alessandrolandra/MFCS/ProjectProposal.txt

Proposal for Project

Proposal for Project - The moth flight control system (@Luca.Dalmasso @Omar Gai @Alessandro Landra)
The platform and architecture of interest: STM32F4xx microcontroller

A short description about the target application and context in which the firmware module can be implemented:
Application – The moth flight control system aims at replacing the standard mechanical control that allow the moth class skiffs to “fly” over the sea, with an electronic one, which determines the height of the boat using ultrasonic sensors and IMU, and changes consequently the angle of the flap mounted on the drift, to maintain a certain distance from the sea surface. This project comes from a real need of the Polito Sailing Team, a student team which designs and produces racing sailing skiffs and who aims at introducing physically this type of control system.
Target of the Project - Development of a firmware module for reading data from ultrasonic sensors, interfaced by HC-SR04 drivers (specific circuit JSN-SR04T-3.0), and an inertial platform (Bosch & Hillcrest BNO085) connected through I2C. This data must act as input of a software PID controller that determines the PWM parameters to be sent to a servo motor, to further change the angle of the flap.
Link to example code that can be used as starting point for the development of the firmware modules:
HC-SR04 https://stm32f4-discovery.net/2014/08/library-30-measure-distance-hc-sr04-stm32f4xx/
I2C https://stm32f4-discovery.net/2014/05/library-09-i2c-for-stm32f4xx/
PWM http://stm32f4-discovery.net/2014/05/stm32f4-stm32f429-discovery-pwm-tutorial/
UART and Flash https://stm32f4-discovery.net/2017/07/stm32-tutorial-efficiently-receive-uart-data-using-dma/
 
Link to datasheets and programming manuals:
Microcontroller documentation https://www.st.com/en/microcontrollers-microprocessors/stm32f4-series.html 
Generic datasheet (precise model of the F4 series still to be selected) https://www.st.com/resource/en/datasheet/stm32f407vg.pdf
BNO085 datasheet https://learn.adafruit.com/adafruit-9-dof-orientation-imu-fusion-breakout-bno085
Programming manual https://www.st.com/resource/en/programming_manual/dm00046982-stm32-cortexm4-mcus-and-mpus-programming-manual-stmicroelectronics.pdf
