alessandrolandra/MFCS/test/LedSwitch/docs/schematics/Schermata 2021-11-29 alle 18.59.03.png

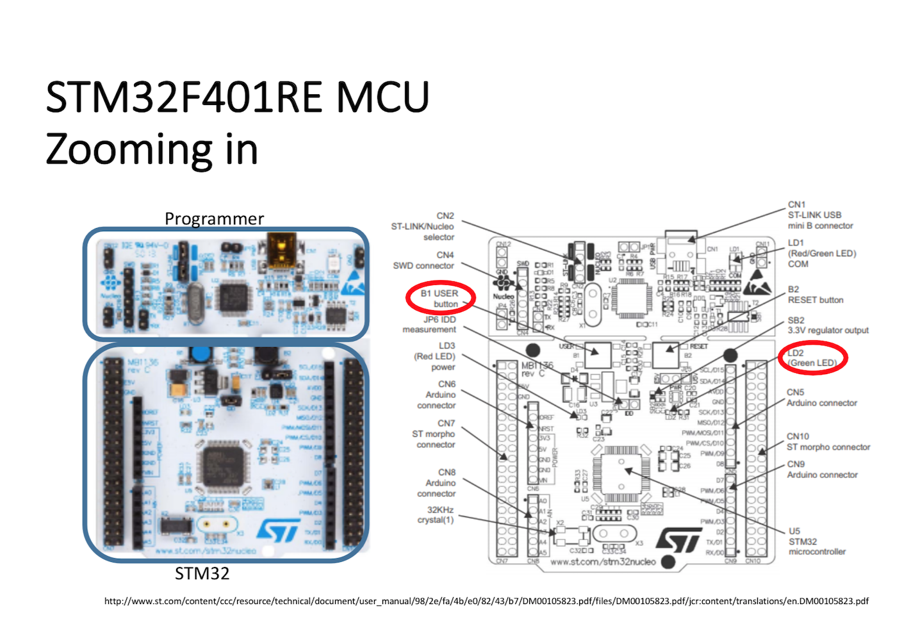
test/LedSwitch/docs/schematics/Schermata 2021-11-29 alle 18.59.03.png
