alessandrolandra/MFCS/test/LedSwitch/docs/schematics/Schermata 2021-11-29 alle 19.00.48.png

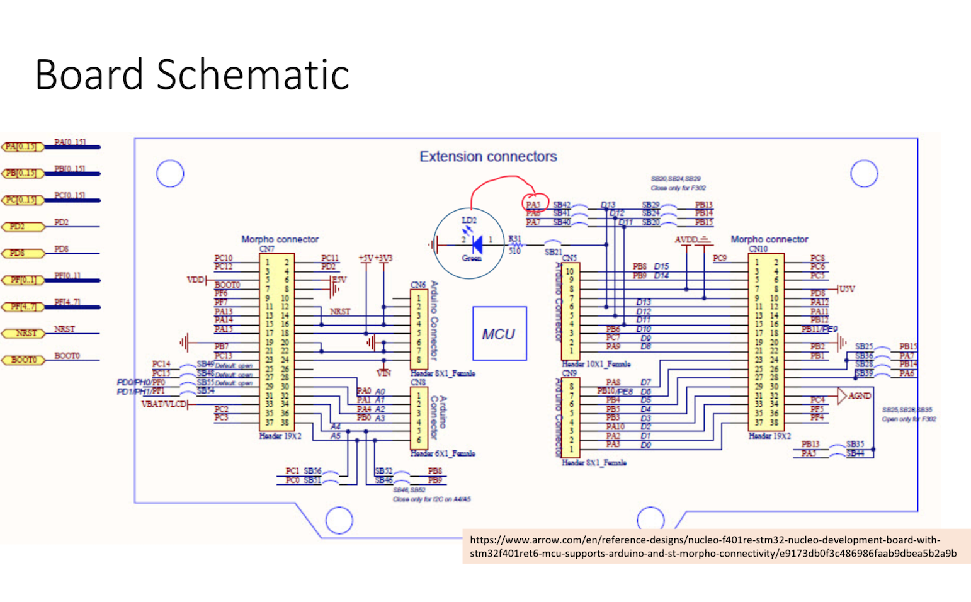
test/LedSwitch/docs/schematics/Schermata 2021-11-29 alle 19.00.48.png
