alessandrolandra/MFCS/test/simulation/Data_Second_Flight_Test.csv

Time | Input | Output | Setpoint | Kp | Kd | Ki | aX | aY | aZ | tmp | gX | gY | gZ
599 | 735.00 | 950.00 | 692.00 | 1.66 | 0.00 | 0.00 | -400 | -6772 | -15056 | 10.79 | 212 | 436 | 44
761 | 736.00 | 950.00 | 693.00 | 1.66 | 0.00 | 0.00 | 1360 | -8236 | -14508 | 10.88 | -77 | 547 | 392
925 | 739.00 | 950.00 | 693.00 | 1.66 | 0.00 | 0.00 | -460 | -6940 | -12480 | 10.93 | 25 | 606 | 482
1089 | 743.00 | 950.00 | 693.00 | 1.66 | 0.00 | 0.00 | 180 | -7828 | -13124 | 10.98 | 9 | 540 | 408
1253 | 748.00 | 950.00 | 693.00 | 1.66 | 0.00 | 0.00 | -728 | -5376 | -11772 | 11.07 | 116 | 451 | 426
1418 | 753.00 | 950.00 | 693.00 | 1.66 | 0.00 | 0.00 | -1176 | -6364 | -11456 | 11.02 | 65 | 328 | 356
1586 | 761.00 | 950.00 | 693.00 | 1.66 | 0.00 | 0.00 | 92 | -8532 | -14724 | 10.98 | -271 | 499 | 334
1751 | 762.00 | 950.00 | 693.00 | 1.66 | 0.00 | 0.00 | -2104 | -7900 | -13344 | 11.02 | 384 | 84 | -69
1914 | 763.00 | 950.00 | 693.00 | 1.66 | 0.00 | 0.00 | 760 | -4708 | -9288 | 11.02 | 181 | 53 | -240
2079 | 762.00 | 950.00 | 693.00 | 1.66 | 0.00 | 0.00 | 1276 | -7852 | -10448 | 10.98 | 179 | 835 | -299
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
