alessandrolandra/MFCS/test/testDelayTrigger/pic_15_1.bmp

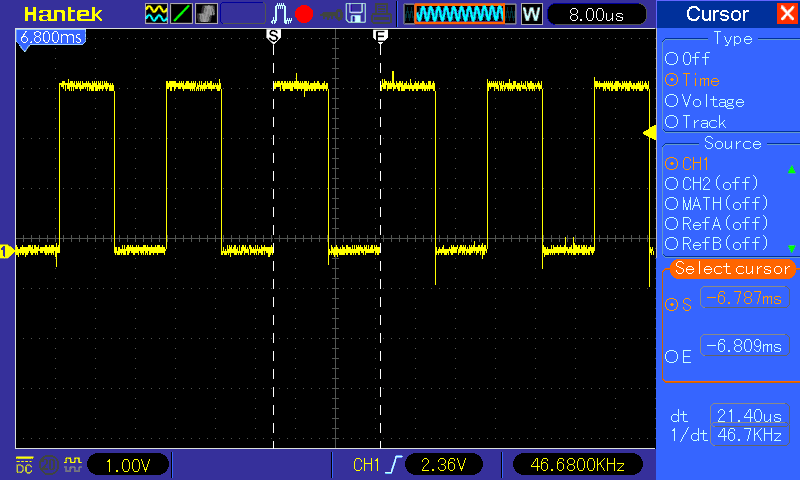
test/testDelayTrigger/pic_15_1.bmp
