alessandrolandra/MFCS/test/testDelayTrigger/pic_15_2.bmp

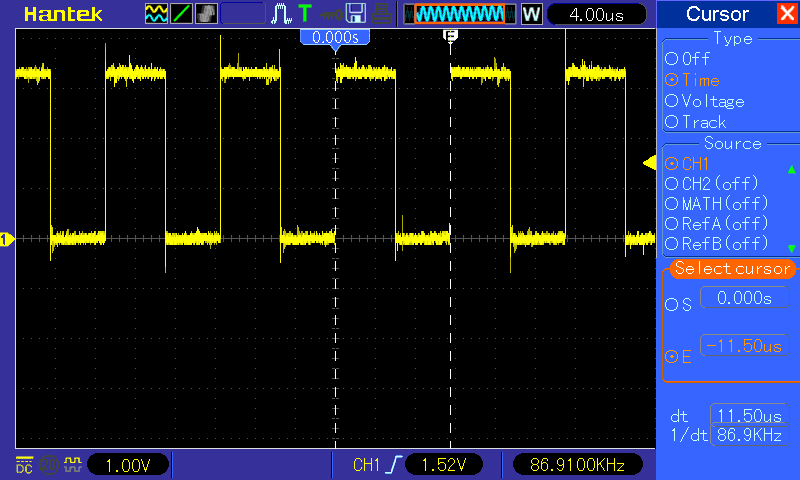
test/testDelayTrigger/pic_15_2.bmp
