alessandrolandra/MFCS/test/testDelayTrigger/pic_15_3.bmp

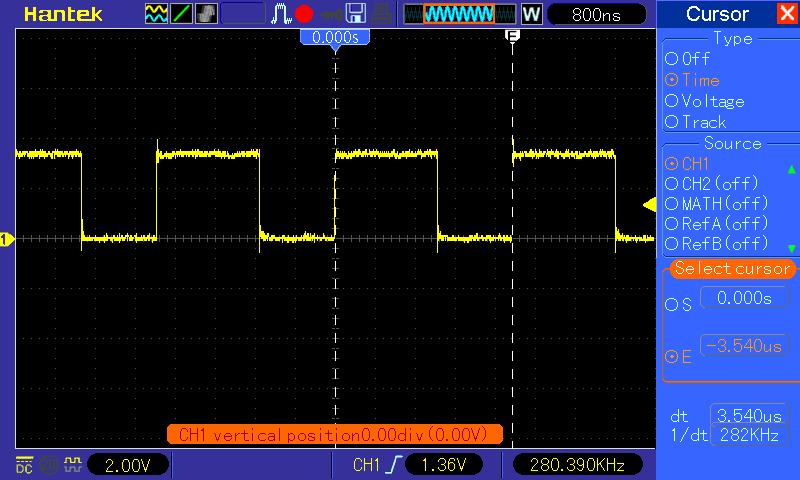
test/testDelayTrigger/pic_15_3.bmp
