alessandrolandra/MFCS/src/MFCS/src/main.c

#include <stm32f411xe.h>//oppure: #include "stm32f4xx.h"
#include "arm_math.h"
#include "MFRC522.h"
#include <stdio.h> // just for test purposes

//target height in mm
#define TARGET1 1000
#define TARGET2 850
#define TARGET3 700

//sensibility threshold in mm (how much distance from the target to change PID parameters)
#define SENS1 50
#define SENS2 75
#define SENS3 100

#define AGG_KP 4
#define AGG_KI 0.2
#define AGG_KD 1

#define CONS_KP 1
#define CONS_KI 0.05
#define CONS_KD 0.25

//ULTRASONIC
#define UTR1
//#define UTR1 //comment if ultrasonic sensor 1 is not present
#define trigPin1  0
#define echoPin1  3
//#define UTR2 //comment if ultrasonic sensor 2 is not present
#define trigPin2  1
#define echoPin2  4
//#define UTR3 //comment if ultrasonic sensor 3 is not present
#define trigPin3  2
#define echoPin3  5

#define CLK_freqMHz 100  //clock frequency equal to 100 MHZ

/* Uncomment to set custom pulse length for 0° rotation */
//#define SERVO_MICROS_MIN    1000
 
/* Uncomment to set custom pulse length for 180° rotation */
//#define SERVO_MICROS_MAX    2000

__IO uint32_t msTick;// tick counter

const char Mx1[7][5]={{0x12,0x45,0xF2,0xA8},{0xB2,0x6C,0x39,0x83},{0x55,0xE5,0xDA,0x18},{0x1F,0x09,0xCA,0x75},{0x99,0xA2,0x50,0xEC},{0x2C,0x88,0x7F,0x3D}}; //card identifier 

int abs(int x);
void updateAngle(arm_pid_instance_q31* PID,int8_t target,int8_t sens_threshold);
int8_t readRFID();
volatile int64_t startTime1, startTime2, startTime3;
volatile float distance1 = 0, distance2 = 0, distance3 = 0;

unsigned long getCurrentUS();

int main(){
  static arm_pid_instance_q31 PID;
  static int16_t target=TARGET1;
  static int8_t sens_threshold=SENS1;
  //static TM_SERVO_t srv;

  PID.Kp = AGG_KP;
  PID.Ki = AGG_KI;
  PID.Kd = AGG_KD;

  /* Initialize PID system, integer format */
  arm_pid_init_q31(&PID, 1);

  /*myPID.SetMode(AUTOMATIC);
  myPID.SetOutputLimits(0, 20);//10-13 degrees down, 8-9 degrees up*/

  /*
  //Timer data for PWM
  TM_PWM_TIM_t TIM_Data;
  //Initialize TIM2, 1kHz frequency
  TM_PWM_InitTimer(TIM2, &TIM_Data, 1000);    
  //Initialize TIM2, Channel 1, PinsPack 2 = PA5
  TM_PWM_InitChannel(&TIM_Data, TM_PWM_Channel_1, TM_PWM_PinsPack_2);    
  //Set default duty cycle
  TM_PWM_SetChannelPercent(&TIM_Data, TM_PWM_Channel_1, duty);

  //Set PWM duty cycle for DC FAN to cool down sensor for "TEMP_CURRENT"
  TM_PWM_SetChannelPercent(&TIM_Data, TM_PWM_Channel_1, duty);
  */

  SystemInit();
  myGPIO_INIT();
  USCounter_INIT();

  //TM_SERVO_Init(&srv, TIM2, TM_PWM_Channel_1, TM_PWM_PinsPack_2);
 
  #ifdef UTR1
    triggerMeasure(trigPin1, echoPin1);
  #endif
  #ifdef UTR2
    triggerMeasure(trigPin2, echoPin2);
  #endif
  #ifdef UTR3
    triggerMeasure(trigPin3, echoPin3);
  #endif

  // Update SystemCoreClock variable
  SystemCoreClockUpdate();
  // Make SysTick overflow every 1ms
  // The SysTick clock source is 168 MHz so 168,000,000 ticks per second. The time required to make one tick is 1 ÷ 168,000,000 ≈ 5.952 ns
  // 1,000,000 ÷ 5.952 ≈ 168,010.752 ticks. But, the data type of input parameter of that function is uint32_t so: 168,000. SystemCoreClock is a global variable that contains the system frequency which is 168MHz
  SysTick_Config(SystemCoreClock / 1000);

  MFRC522_Init();

  while (1) {
    updateAngle(&PID,target,sens_threshold);
    // Set delay to 500ms
    msTick = 500;
    // Do nothing until msTick is zero
    while (msTick);
  } 
}

void updateAngle(arm_pid_instance_q31* PID,int8_t target,int8_t sens_threshold){
  int16_t measuredHeight,gap;
  int8_t rotationAngle;

  //measuredHeight = (int)(((distance2+distance3)/2)+distance1)/2;
  measuredHeight = 0;
  gap = abs(measuredHeight - target);
  if (gap < sens_threshold){//close to target, use conservative tuning parameters
    PID->Kp = CONS_KP;
    PID->Ki = CONS_KI;
    PID->Kd = CONS_KD;
  }else{//far from target, use aggressive tuning parameters
    PID->Kp = AGG_KP;
    PID->Ki = AGG_KI;
    PID->Kd = AGG_KD;
  }
          
  /* Calculate PID here, argument is error */
  /* Output data will be returned, we will use it as duty cycle parameter */
  rotationAngle = arm_pid_q31(PID, gap);           
  
  //TM_SERVO_SetDegrees(&srv, rotationAngle);
}

// This function will be called every 1ms
void SysTick_Handler(void){
  msTick--;
}

int abs(int x){
  return x>=0?x:-x;
}

int8_t readRFID(){
  char status,str[90],cardstr[MAX_LEN+1],UID[5],SectorKey[7];
  status = MFRC522_Request(PICC_REQIDL, cardstr);
	if(status == MI_OK) {
	  sprintf(str,"Card:%x,%x,%x", cardstr[0], cardstr[1], cardstr[2]);
	  // Anti-collision, return card serial number == 4 bytes
	  status = MFRC522_Anticoll(cardstr);
	  if(status == MI_OK) {
		  sprintf(str,"UID:%x %x %x %x", cardstr[0], cardstr[1], cardstr[2], cardstr[3]);
		  UID[0] = cardstr[0];
		  UID[1] = cardstr[1];
		  UID[2] = cardstr[2];
		  UID[3] = cardstr[3];
		  UID[4] = cardstr[4];
		  status = MFRC522_SelectTag(cardstr);
		  if (status > 0){
			  SectorKey[0] = ((Mx1[0][0])^(UID[0])) + ((Mx1[0][1])^(UID[1])) + ((Mx1[0][2])^(UID[2])) + ((Mx1[0][3])^(UID[3]));// 0x11; //KeyA[0]
			  SectorKey[1] = ((Mx1[1][0])^(UID[0])) + ((Mx1[1][1])^(UID[1])) + ((Mx1[1][2])^(UID[2])) + ((Mx1[1][3])^(UID[3]));// 0x11; //KeyA[0]
			  SectorKey[2] = ((Mx1[2][0])^(UID[0])) + ((Mx1[2][1])^(UID[1])) + ((Mx1[2][2])^(UID[2])) + ((Mx1[2][3])^(UID[3]));// 0x11; //KeyA[0]
			  SectorKey[3] = ((Mx1[3][0])^(UID[0])) + ((Mx1[3][1])^(UID[1])) + ((Mx1[3][2])^(UID[2])) + ((Mx1[3][3])^(UID[3]));// 0x11; //KeyA[0]
			  SectorKey[4] = ((Mx1[4][0])^(UID[0])) + ((Mx1[4][1])^(UID[1])) + ((Mx1[4][2])^(UID[2])) + ((Mx1[4][3])^(UID[3]));// 0x11; //KeyA[0]
			  SectorKey[5] = ((Mx1[5][0])^(UID[0])) + ((Mx1[5][1])^(UID[1])) + ((Mx1[5][2])^(UID[2])) + ((Mx1[5][3])^(UID[3]));// 0x11; //KeyA[0]
			  status = MFRC522_Auth(0x60, 3, SectorKey, cardstr);
			  if (status == MI_OK){
				  sprintf(str, "Auth. OK");
			  }else{
				  //another sector key
			  }
			  MFRC522_StopCrypto1();
		  }
	  }
	  MFRC522_Halt();
	}else{
	  //Waiting for Card
	}
}

void triggerMeasure(int8_t trig_pin, int8_t echo_pin){
    // Clears the trigPin
    //digitalWrite(trig_pin, GPIO_PIN_RESET);
    HAL_GPIO_WritePin(GPIOA, trig_pin, GPIO_PIN_RESET);
    delayMicroseconds(2);
    // Sets the trigPin on HIGH state for 10 micro seconds
    HAL_GPIO_WritePin(GPIOA, trig_pin, GPIO_PIN_SET);
    delayMicroseconds(10);

    HAL_GPIO_WritePin(GPIOA, trig_pin, GPIO_PIN_RESET);
    //attachInterrupt(echo_pin, start_count_procedure, TRIGGER_RISING);
    HAL_GPIO_EXTI_IRQHandler(echo_pin); //RISING 
    HAL_GPIO_EXTI_IRQHandler(echo_pin); //FALLING
}

/*
void startCount(volatile unsigned long *startTime, int8_t echo_pin,void (*stop_count_procedure)()){
    *startTime = getCurrentUS();
    //attachInterrupt(echo_pin, stop_count_procedure, TRIGGER_FALLING);
}

void stopCount(volatile unsigned long startTime, volatile float *distance,int8_t echo_pin){
    unsigned long durationMicros = startTime - getCurrentUS();
    //the speed of sound, in air, at 20 degrees C is 343m/s... half distance in mm: micros/10^6*343*10^3 /2 = micros*0.1715
    *distance = durationMicros*0.1715;
    //if(!(*distance>=230 && *distance<=4000)){
    //  *distance=-1;
    //}
    //detachInterrupt(echo_pin);   s    
}
*/

void myGPIO_INIT(){

  RCC->AHB1ENR |= 0x1; //0001 IO portA clock enable
  GPIOA -> MODER = 0x00000007; //binary 00..00000111 port A0,A1,A2 set as output;  A3,A4,A5 used as input
  GPIOA -> OTYPER |= 0x0000003F; //00..00111111 to set Push-Pull 
  GPIOA -> PUPDR |= 0x00000AAA; //00.000101010101010 to set as pull down
}

void USCounter_INIT(){
  CoreDebug->DEMCR |= CoreDebug_DEMCR_TRCENA_Msk;
  DWT->CYCCNT = 0;
  DWT->CTRL |= DWT_CTRL_CYCCNTENA_Msk;
}

unsigned long getCurrentUS(){
  return  (unsigned long) DWT->CYCCNT/CLK_freqMHz;
}

void delayMicroseconds(uint8_t delay){
  unsigned long start = getCurrentUS();
  while((getCurrentUS() - start) < delay);
}

/* USER CODE BEGIN 4 */
//This function is called automatically by interrupt controller
void HAL_GPIO_EXTI_Callback(uint16_t GPIO_Pin)
{
  switch (GPIO_Pin)
  {
  case echoPin1:
    //read state of PIN
    if(HAL_GPIO_ReadPin(GPIOA, GPIO_Pin) == RESET){  //low state
      unsigned long durationMicros = startTime1 - getCurrentUS();
      //the speed of sound, in air, at 20 degrees C is 343m/s... half distance in mm: micros/10^6*343*10^3 /2 = micros*0.1715
      distance1 = durationMicros*0.1715;
    }else if(HAL_GPIO_ReadPin(GPIOA, GPIO_Pin)== SET){ //high state
      startTime1 = getCurrentUS();
    } 
    break;
  case echoPin2:
    if(HAL_GPIO_ReadPin(GPIOA, GPIO_Pin) == RESET){  //low state
      unsigned long durationMicros = startTime2 - getCurrentUS();
      //the speed of sound, in air, at 20 degrees C is 343m/s... half distance in mm: micros/10^6*343*10^3 /2 = micros*0.1715
      distance2 = durationMicros*0.1715;
    }else if(HAL_GPIO_ReadPin(GPIOA, GPIO_Pin)== SET){ //high state
      startTime2 = getCurrentUS();
    } 
    break;
  case echoPin3:
    if(HAL_GPIO_ReadPin(GPIOA, GPIO_Pin) == RESET){  //low state
      unsigned long durationMicros = startTime3 - getCurrentUS();
      //the speed of sound, in air, at 20 degrees C is 343m/s... half distance in mm: micros/10^6*343*10^3 /2 = micros*0.1715
      distance3 = durationMicros*0.1715;
    }else if(HAL_GPIO_ReadPin(GPIOA, GPIO_Pin)== SET){ //high state
      startTime3 = getCurrentUS();
    } 
    break;
  }	
}
/* USER CODE END 4 */
