alessandrolandra/MFCS/(commit log)

2021-11-11 feat: third sensor added
2021-11-22 feat: pid controller introduced and servo driver functions added
2021-11-28 feat: PID controller library added and tuning parameters improved
2021-11-30 feat: first STM32 code version
2021-11-30 feat: servo added
2021-11-30 refactor: srv typo solved
    [main.c]
2021-11-30 feat: delay and servo lib added
2021-12-03 stm32f4xx.h added
2021-12-06 Ale GPIO + Count milliseconds
2021-12-21 feat: first complete stm32 ino sketch added
2021-12-27 feat: stm32 pins added and esp32 UTR pins fixed
    [stm32INOsketch.ino]
2021-12-27 feat: IMU ADDED
2022-01-03 feat: gyroscope data considered to adjust measured distances
2022-01-05 refactor: typo in sensThresholds array fixed
    [stm32INOsketch.ino]
2022-01-08 refactor: LedSwitch project moved in test
2022-01-14 UTR pin modified
2022-01-14 refactor: watchdog tested and PID changed
2022-02-03 feat: PID test added
2022-02-11 FEAT: simulation for PID characterization
    [Data_Second_Flight_Test.csv]
2022-02-13 feat: pid simulation script improved
2022-02-14 Board connections added
2022-02-17 refactor: PID and IMU improved
2022-02-23 refactor: last changes to PID parameters
2022-02-24 feat: schematic added
2022-02-24 refactor: schematic image made visible
2022-02-25 refactor: IMU calibration condition changed
2022-03-10 feat: sensor and actuators driver details added
